Wai-0424/501b-ai-car-ble-control/firmware/tests/i2c_scan/i2c_scan.ino

#include <Wire.h>

void setup() {
  Serial.begin(115200);
  Wire.begin();
  Serial.println("I2C0 (main header, D18/A4=SDA, D19/A5=SCL) scan starting...");
}

void loop() {
  byte count = 0;
  for (byte addr = 1; addr < 127; addr++) {
    Wire.beginTransmission(addr);
    byte err = Wire.endTransmission();
    if (err == 0) {
      Serial.print("Found device at 0x");
      Serial.println(addr, HEX);
      count++;
    }
  }
  Serial.print("Total: ");
  Serial.println(count);
  delay(3000);
}
