Wai-0424/501b-ai-car-ble-control/(commit log)

2026-08-25 Baseline: working BLE remote-control car (app + firmware)
    Android app (Kotlin/Compose): scans for BMC_CAR, connects over the
    BM7701-00-1 GATT service (FFF0/FFF1/FFF2), dual single-axis joysticks
    (throttle + steering) sending a 3-byte move packet at ~20Hz, snap-back
    to neutral on release/disconnect.
    BMduino firmware (car_control.ino): decodes the move packet, drives
    XY-160D direction via PCA9685 CH1/CH2 and speed via D5->74HC14->ENA,
    steering via PCA9685 CH0 (calibrated center 130 deg, +-30 deg range),
    300ms watchdog failsafe (brake + re-center) on link loss.
    Bench-tested end to end: I2C, servo endpoints, motor direction/speed,
    BLE pairing and echo, and live joystick control all confirmed w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
    [ble_echo.ino]
2026-08-25 Note v1.0-baseline checkpoint in CALIBRATION.md
    Records that the app+firmware pair is bench-verified and tagged before
    starting on the steering linkage mechanical adjustment, so a changed
    CENTER/STEER_OFFSET afterward reads as expected re-calibration rather
    than a regression.
2026-08-29 Reorganize project layout, recalibrate steering servo, add BLE module datasheets
    - Move firmware sketches into firmware/ (car_control main + tests/ for
    the calibration/debug sketches), move CALIBRATION.md and the new
    project report into docs/
    - Steering servo recalibration: mechanical center 130 -> 90 deg,
    STEER_OFFSET 30 -> 70 deg (horn re-mounted at true center)
    - Add BMC77M001/BM7701-00-1 vendor datasheets and Arduino library guide
    to docs/datasheets/BMC77M001/ for offline reference
    - Add AI自走車_BLE遙控系統技術報告.docx covering app/firmware/hardware
    architecture for onboarding
